m-lmq/Interactive-Lab-Hub/Final/card_dispenser.3mf

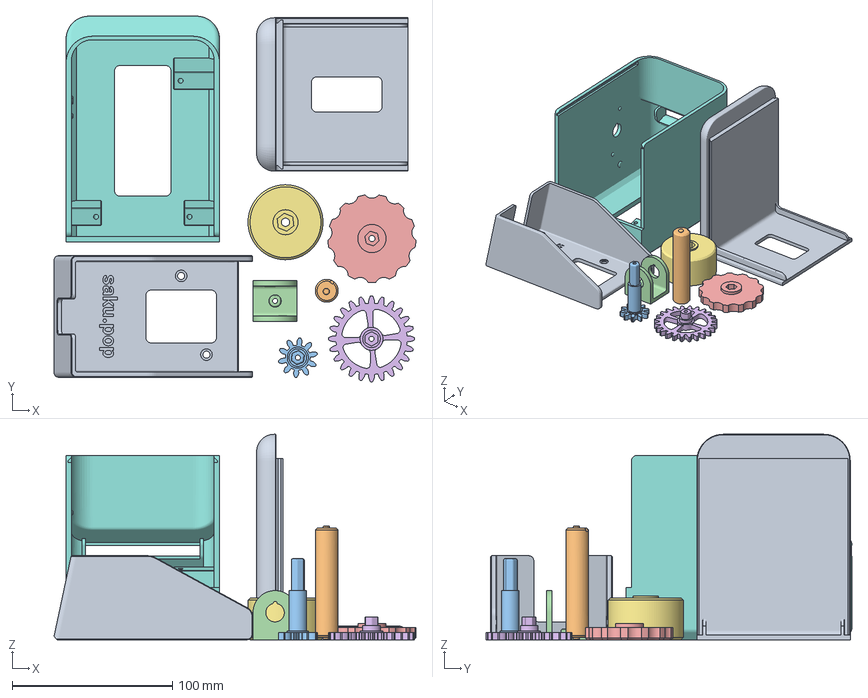
[picture p1: CAD file, 2025-12-14]
Final/card_dispenser.3mf
225.8 x 228.0 x 128.2 mm
Lid Mini V2.stl
Front Roller Mini.stl
Roller Gear Mini.stl
RG Mount Mini 2.85mm.stl
Knob Mini.stl
Main Gear.stl
Roller Solid SE 4.35mm ins.stl
Casing Mini M3.stl
Card Tray M3.stl
